matias-novillo/heart-led-pcb/images/pcb-layout.png

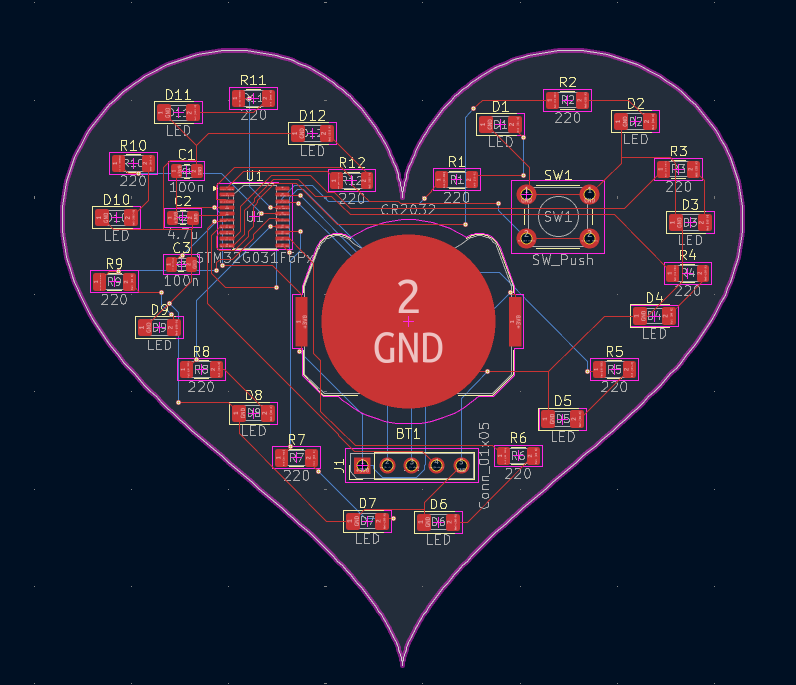
images/pcb-layout.png
