matias-novillo/heart-led-pcb/docs/schematic.pdf

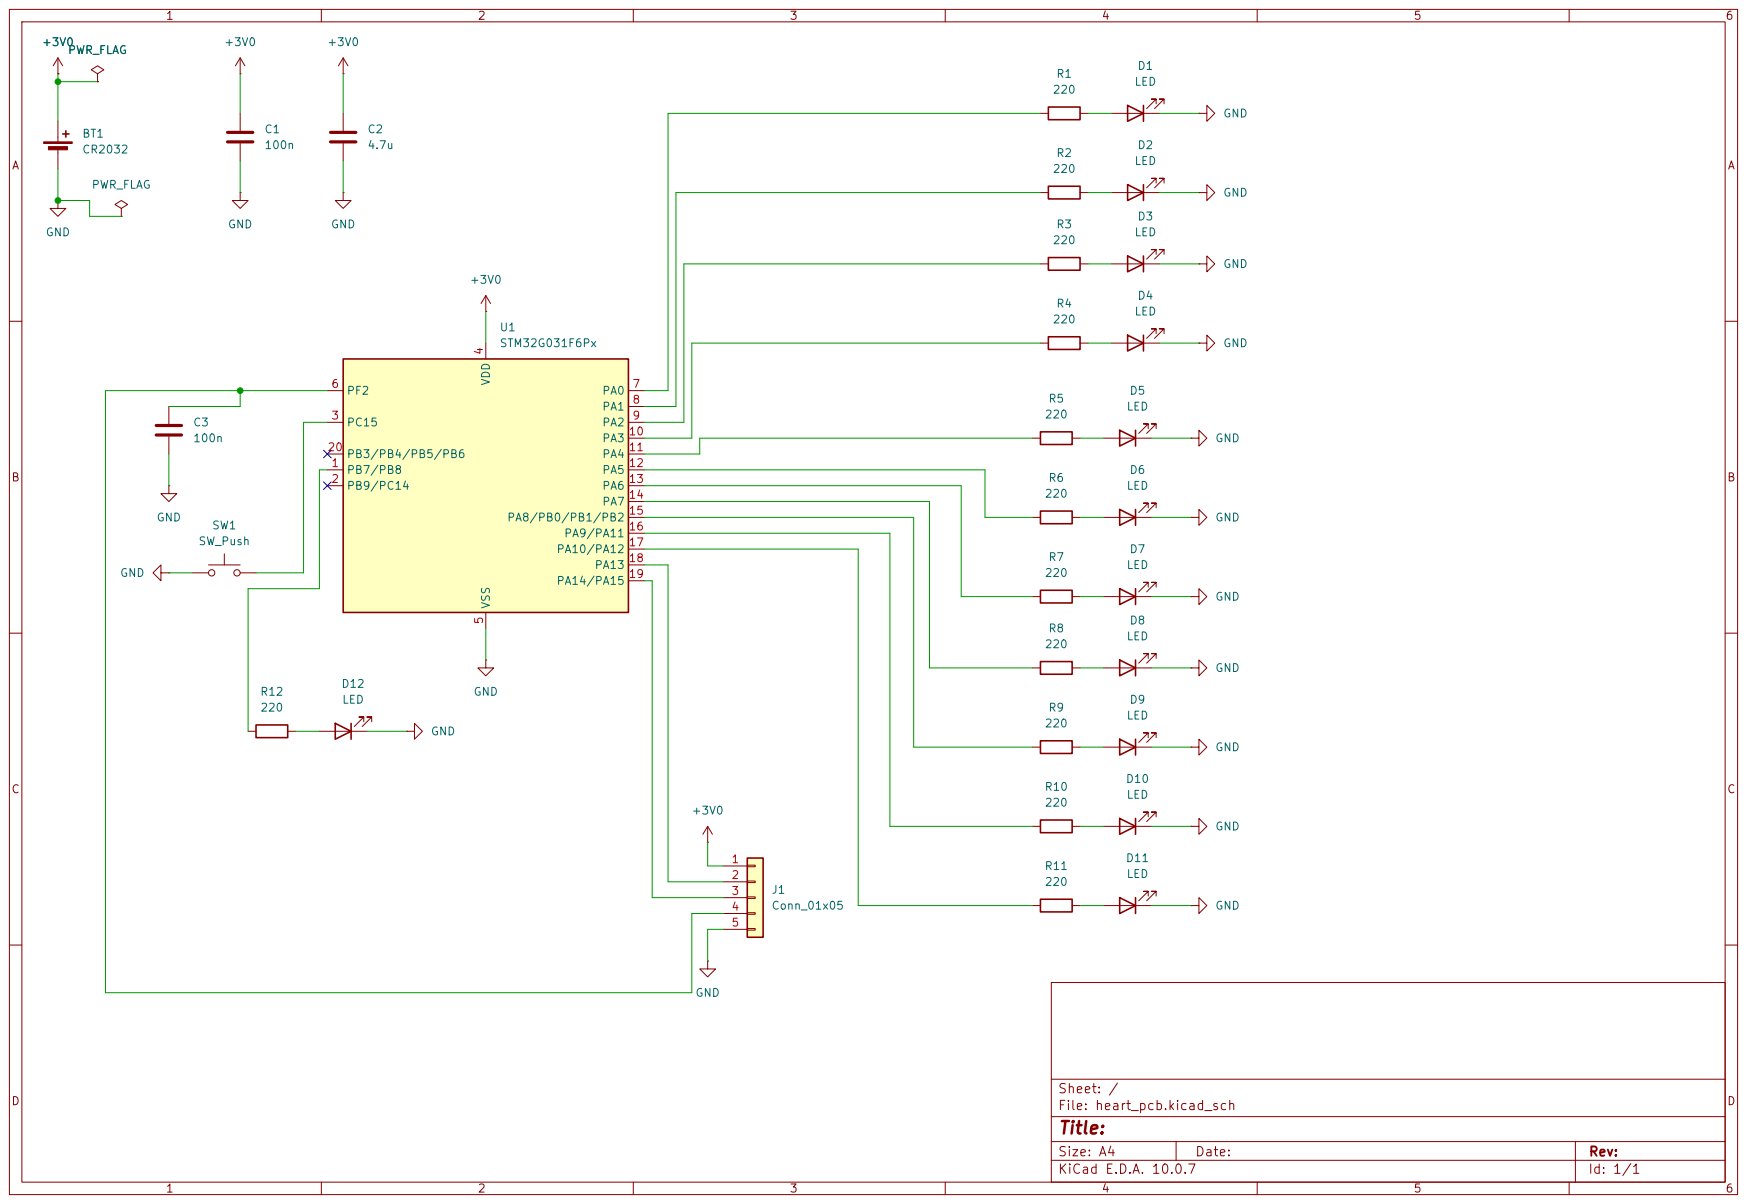
[picture p3: page 1]

Size: A4 | Rev:
KiCad E.D.A. 10.0.7 | Id: 1/1
