matias-novillo/heart-led-pcb/hardware/heart_pcb.kicad_pcb

## KiCad design hardware/heart_pcb.kicad_pcb (2026-11-09)

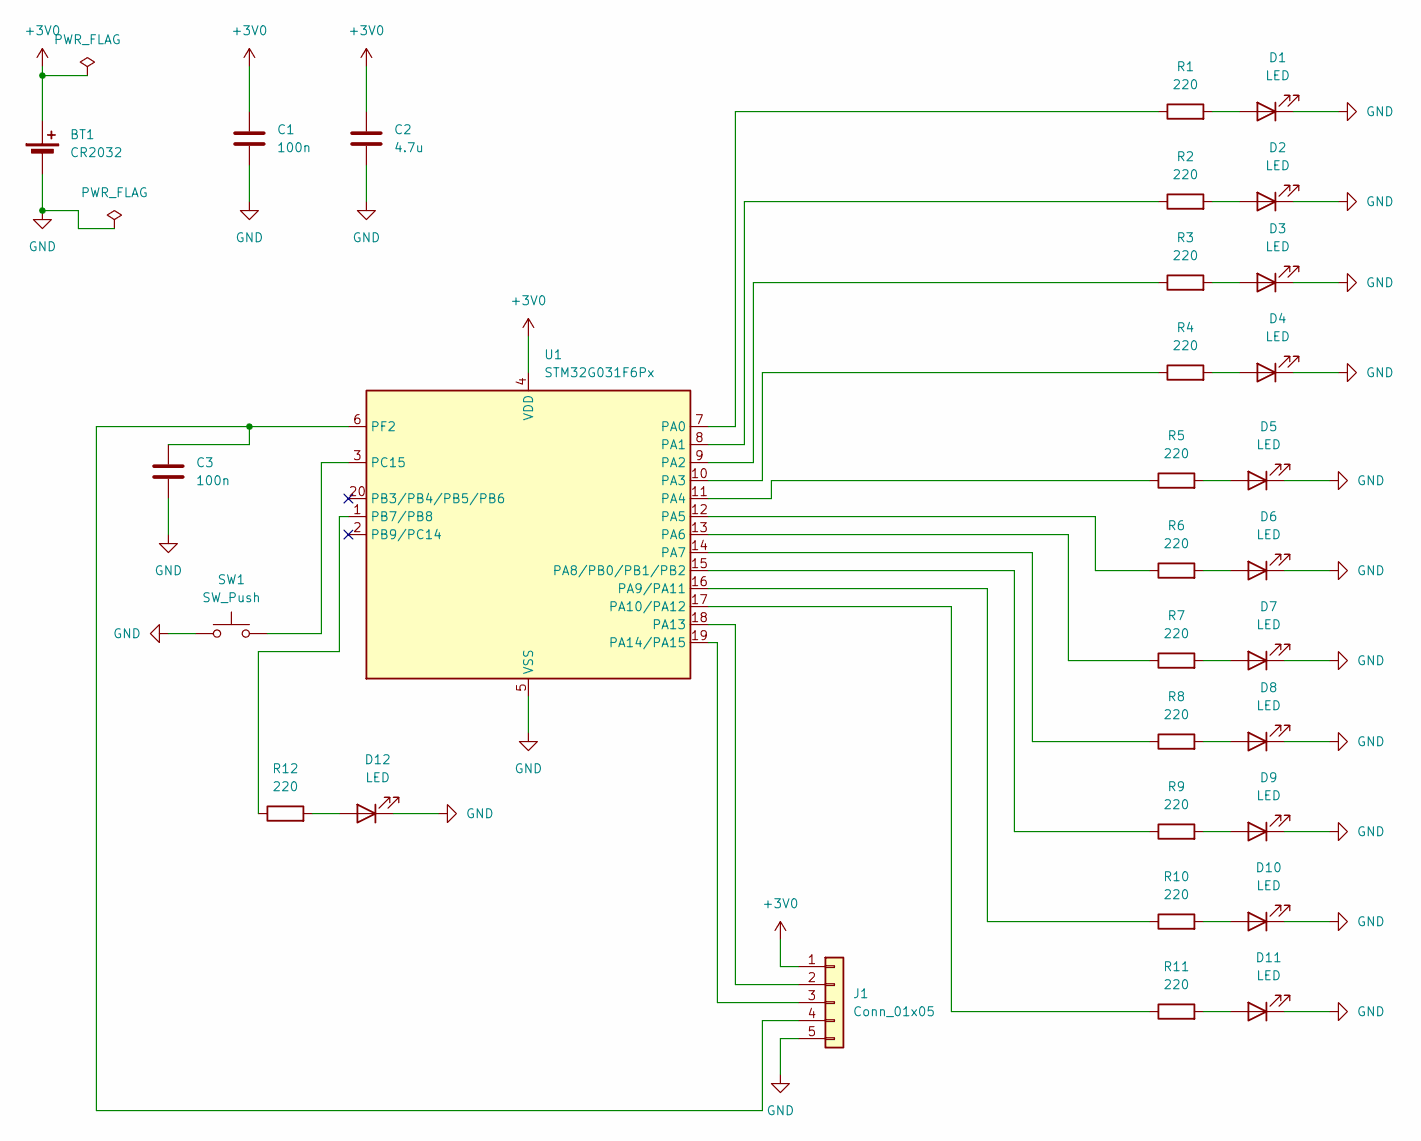
[picture p4: schematic heart_pcb.kicad_sch]

Parts:
BT1: CR2032; BatteryHolder_Keystone_3034_1x20mm
C1, C3: 100n; C_0805_2012Metric_Pad1.18x1.45mm_HandSolder
C2: 4.7u; C_0805_2012Metric_Pad1.18x1.45mm_HandSolder
D1, D2, D3, D4, D5, D6, D7, D8, D9, D10, D11, D12: LED; LED_1206_3216Metric_Pad1.42x1.75mm_HandSolder
J1: Conn_01x05; PinHeader_1x05_P2.54mm_Vertical
R1, R2, R3, R4, R5, R6, R7, R8, R9, R10, R11, R12: 220; R_1206_3216Metric_Pad1.30x1.75mm_HandSolder
SW1: SW_Push; SW_PUSH_6mm
U1: STM32G031F6Px; TSSOP-20_4.4x6.5mm_P0.65mm

Connections:
+3V0: BT1.1 (+), C1.1, C2.1, J1.1, U1.4 (VDD)
GND: BT1.2 (-), C1.2, C2.2, C3.2, D1.1 (K), D2.1 (K), D3.1 (K), D4.1 (K), D5.1 (K), D6.1 (K), D7.1 (K), D8.1 (K), D9.1 (K), D10.1 (K), D11.1 (K), D12.1 (K), J1.5, SW1.1, U1.5 (VSS)
unnamed: D1.2 (A), R1.2
unnamed: D2.2 (A), R2.2
unnamed: D3.2 (A), R3.2
unnamed: D4.2 (A), R4.2
unnamed: D5.2 (A), R5.2
unnamed: D6.2 (A), R6.2
unnamed: D7.2 (A), R7.2
unnamed: D8.2 (A), R8.2
unnamed: D9.2 (A), R9.2
unnamed: D10.2 (A), R10.2
unnamed: D11.2 (A), R11.2
unnamed: D12.2 (A), R12.2
unnamed: J1.2, U1.18 (PA13)
unnamed: J1.3, U1.19 (PA14/PA15)
unnamed: C3.1, J1.4, U1.6 (PF2)
unnamed: R1.1, U1.7 (PA0)
unnamed: R2.1, U1.8 (PA1)
unnamed: R3.1, U1.9 (PA2)
unnamed: R4.1, U1.10 (PA3)
unnamed: R5.1, U1.11 (PA4)
unnamed: R6.1, U1.12 (PA5)
unnamed: R7.1, U1.13 (PA6)
unnamed: R8.1, U1.14 (PA7)
unnamed: R9.1, U1.15 (PA8/PB0/PB1/PB2)
unnamed: R10.1, U1.16 (PA9/PA11)
unnamed: R11.1, U1.17 (PA10/PA12)
unnamed: R12.1, U1.1 (PB7/PB8)
unnamed: SW1.2, U1.3 (PC15)

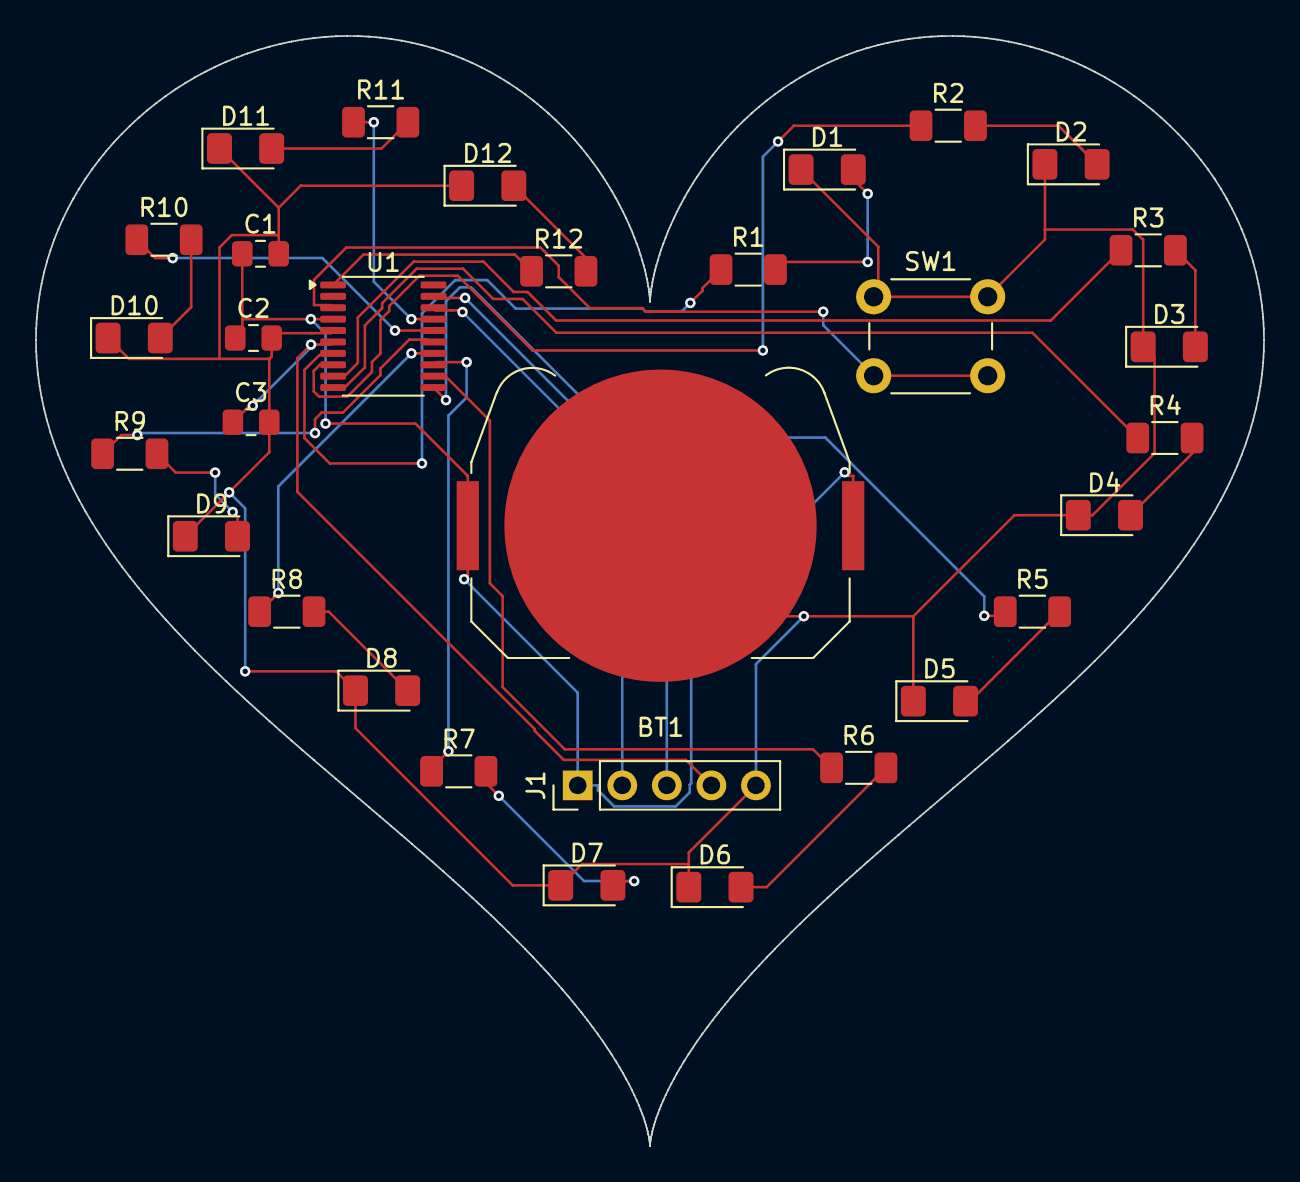
[picture p5: board heart_pcb.kicad_pcb from above]

Board: 2 copper layers, 70.0 x 63.3 mm, 31 parts (0 on the bottom side), 30 nets.
